pluggee/R1008/README.md

# R1008
Dual Platinum RTD Sensors
License
-------
R1008 is released under the GNU GPL v3, which you can find at <http://www.gnu.org/licenses/gpl-3.0.en.html>,
Check License.md for more details.
