pluggee/R1008/(threads)

Thread 2 (2017-03-24):

Fix silkscreen for signal polarity

pluggee, 2017-03-24:
Fix R1008 silkscreen, 1F+ instead of 1S+

Thread 4 (2017-06-26):

Fix BOM with 10k flash MCU instead of 2k

pluggee, 2017-06-26:
