pluggee/R1008/pcb/R1008.kicad_pcb

## KiCad design pcb/R1008.kicad_pcb (2017-06-27)

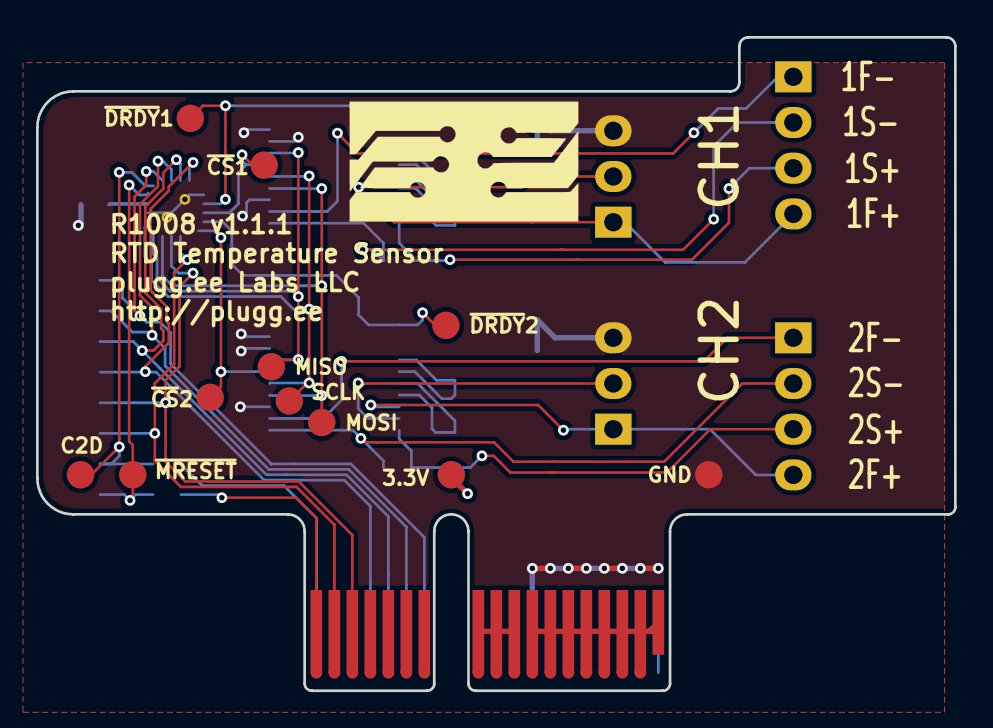
[picture p1: board R1008.kicad_pcb from above]

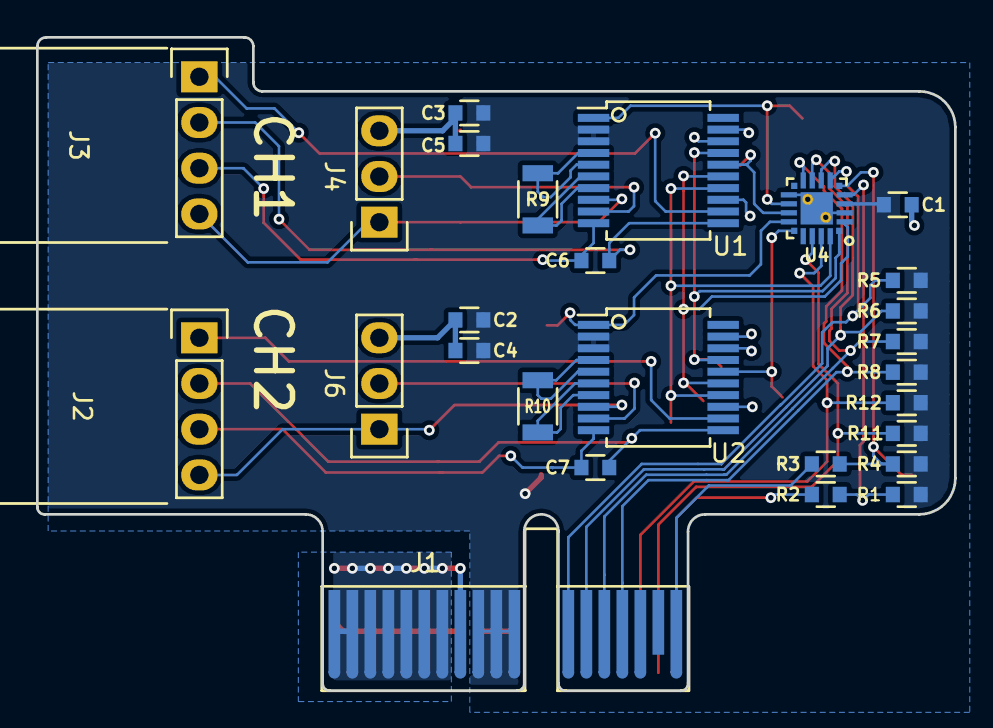
[picture p2: board R1008.kicad_pcb from below]

Board: 2 copper layers, 51.0 x 36.3 mm, 39 parts (27 on the bottom side), 35 nets.

Parts:
A1: ART; pluggeeLabsIcon-13X7
C1, C2, C3, C4, C5, C6, C7: CC0603KRX7R9BB104; CAPC0603
J1: PCIEXPRESS-X1
J2, J3: SOCKET254P-01X04-1725672; 70553-0038
J4, J6: CONN_01X03; CONN254P-01X03
R1, R4, R5, R6, R7, R8, R11, R12: RC0603FR-0710KL; RESC0603
R2, R3: RC0603FR-071KL; RESC0603
R9, R10: RN732BTTD4000B25; RESC1206
TP1, TP2, TP3, TP4, TP5, TP6, TP7, TP8, TP9, TP10, TP11: TestPoint; TestPoint000
U1, U2: MAX31865AAP+; SOP65P720X530X186-20
U4: EFM8BB10F8G; QFN50P300X300X75-20NT170X170

Connections:
+3V3: C1.1, C2.1, C3.1, C4.1, C5.1, J1.B9, J1.B10, J1.B11, R1.2, R4.2, R5.2, R6.2, R7.2, R8.2, R11.2, R12.2, TP1.1, U1.2, U1.3, U2.2, U2.3, U4.4
+5V: J1.A9, J1.A10, J1.A11
/C2D_CON: J1.B18, R3.2
/FORCE2_1: J4.2, U1.9
/FORCE2_2: J6.2, U2.9
/FORCE+_1: J3.4, J4.1, U1.8
/FORCE+_2: J2.4, J6.1, U2.8
/FORCE-_1: J3.1, U1.12
/FORCE-_2: J2.1, U2.12
/MISO: TP7.1, U1.17, U2.17, U4.1
/MOSI: TP9.1, U1.14, U2.14, U4.20
/R+_1: R9.1, U1.4, U1.5
/R+_2: R10.1, U2.4, U2.5
/R-_1: R9.2, U1.6, U1.7
/R-_2: R10.2, U2.6, U2.7
/RTDIN+_1: C6.1, J3.3, U1.10
/RTDIN+_2: C7.1, J2.3, U2.10
/RTDIN-_1: C6.2, J3.2, U1.11
/RTDIN-_2: C7.2, J2.2, U2.11
/SCLK: TP5.1, U1.15, U2.15, U4.2
/~CS~1: TP8.1, U1.16, U4.14
/~CS~2: TP11.1, U2.16, U4.16
/~DRDY~1: TP6.1, U1.1, U4.13
/~DRDY~2: TP10.1, U2.1, U4.15
/~MRESET~_CON: J1.A18, R2.1
C2D: R3.1, R4.1, TP3.1, U4.6
GND: C1.2, C2.2, C3.2, C4.2, C5.2, J1.B1, J1.B2, J1.B3, J1.B4, J1.B5, J1.B6, J1.B7, J1.B8, J4.3, J6.3, TP2.1, U1.13, U1.18, U1.19, U2.13, U2.18, U2.19, U4.3, U4.12, U4.21
HT: J1.A1, J1.A2, J1.A3, J1.A4, J1.A5, J1.A6, J1.A7, J1.A8
ID0: J1.B12, R5.1, U4.7
ID1: J1.B13, R6.1, U4.8
ID2: J1.B14, R7.1, U4.9
ID3: J1.B15, R8.1, U4.10
SCL: J1.A16, R12.1, U4.19
SDA: J1.A17, R11.1, U4.18
~MRESET: R1.1, R2.2, TP4.1, U4.5
