pluggee/R1008/firmware/R1008_bl/inc/smb.h

/*
 * smb.h
 *
 *  Created on: Feb 12, 2017
 *      Author: sherifeid
 */

#ifndef SMB_H_
#define SMB_H_

#define  WRITE                    0x00 // SMBus WRITE command
#define  READ                     0x01 // SMBus READ command

// Status vector - top 4 bits only
#define  SMB_SRADD                0x20 // (SR) slave address received
                                       //    (also could be a lost
                                       //    arbitration)
#define  SMB_SRSTO                0x10 // (SR) STOP detected while SR or ST,
                                       //    or lost arbitration
#define  SMB_SRDB                 0x00 // (SR) data byte received, or
                                       //    lost arbitration
#define  SMB_STDB                 0x40 // (ST) data byte transmitted
#define  SMB_STSTO                0x50 // (ST) STOP detected during a


void SetI2CSlaveAddress (void);
void SMBHandler(void);

#endif /* SMB_H_ */
