pluggee/R1008/firmware/R1008_fw/inc/EFM8BB1_SPI0_Master.h

//-----------------------------------------------------------------------------
// EFM8BB1_SPI0_Master.h
//-----------------------------------------------------------------------------
// Copyright 2014 Silicon Laboratories, Inc.
// http://developer.silabs.com/legal/version/v11/Silicon_Labs_Software_License_Agreement.txt
//
// Header for main file:

#ifndef SPI0_MASTER_H_
#define SPI0_MASTER_H_

//-----------------------------------------------------------------------------
// Global Constants
//-----------------------------------------------------------------------------

#define SYSCLK                24500000 // Internal oscillator frequency in Hz

#define SPI_CLOCK               500000 // Maximum SPI clock
                                       // The SPI clock is a maximum of 1 MHz
                                       // when this example is used with
                                       // the SPI0_Slave code example.

#define MAX_BUFFER_SIZE              8 // Maximum buffer Master will send

// Instruction Set
//#define  SLAVE_LED_ON             0x01 // Turn the Slave LED on
//#define  SLAVE_LED_OFF            0x02 // Turn the Slave LED off
#define  SPI_WRITE                0x04 // Send a byte from the Master to the
                                       // Slave
#define  SPI_READ                 0x08 // Send a byte from the Slave to the
                                       // Master
#define  SPI_WRITE_BUFFER         0x10 // Send a series of bytes from the
                                       // Master to the Slave
#define  SPI_READ_BUFFER          0x20 // Send a series of bytes from the Slave
                                       // to the Master
#define  ERROR_OCCURRED           0x40 // Indicator for the Slave to tell the
                                       // Master an error occurred

//-----------------------------------------------------------------------------
// Global Variables
//-----------------------------------------------------------------------------

extern uint8_t SPI_Data;

extern uint8_t SPI_Data_Array[MAX_BUFFER_SIZE];

extern bit Error_Flag;

extern uint8_t Command;

#endif // SPI0_MASTER_H_
//-----------------------------------------------------------------------------
// End Of File
//-----------------------------------------------------------------------------
