pluggee/R1008/(commit log)

2016-12-13 first commit, added pcb project
    [R1008.kicad_pcb, R1008.sch]
2016-12-14 ready for release, gerbers updated
    [R1008-B.Cu.gbr, R1008-B.Mask.gbr, R1008-B.Paste.gbr, R1008-B.SilkS.gbr, R1008-Edge.Cuts.gbr, R1008-F.Cu.gbr, R1008-F.Mask.gbr, R1008-F.Paste.gbr]
2016-12-14 re-confirmed gerbers, ready for release
    [R1008-B.Cu.gbr, R1008-B.Mask.gbr, R1008-B.Paste.gbr, R1008-B.SilkS.gbr, R1008-Edge.Cuts.gbr, R1008-F.Cu.gbr, R1008-F.Mask.gbr, R1008-F.Paste.gbr]
2017-01-11 updated BOM
    [R1008_BOM.csv]
2017-04-23 wip, ADC outputs are clean, theres a problem with FP calculations on 8bit mcu
    [R1008_fw_main.c, global.h, max31865.c, max31865.h]
2017-04-24 completely functional, got rid of casting problem that was causing weird floating point operations
    [R1008_fw_main.c, global.h, max31865.c, max31865.h]
2017-04-24 cleaned up code, still need to add code to measure internal die temeprature
2017-04-25 added internal temperature monitor, cleaned up, not properly documented yet
2017-04-27 added BOM, selected proper part for jumpers, added test points
    [R1008-B.Cu.gbr, R1008-B.Mask.gbr, R1008-B.Paste.gbr, R1008-B.SilkS.gbr, R1008-Edge.Cuts.gbr, R1008-F.Cu.gbr, R1008-F.Mask.gbr, R1008-F.Paste.gbr]
2017-04-27 regenerated gerbers
    [R1008-B.Cu.gbr, R1008-B.Mask.gbr, R1008-B.Paste.gbr, R1008-B.SilkS.gbr, R1008-Edge.Cuts.gbr, R1008-F.Cu.gbr, R1008-F.Mask.gbr, R1008-F.Paste.gbr]
2017-05-01 updated BOM with proper connector
    [R1008.sch, R1008_BOM.csv, R1008_BOM.ods, R1008_BOM.xlsx]
2017-06-27 ready for v1.1.1 release
    [R1008-B.Cu.gbr, R1008-B.Mask.gbr, R1008-B.Paste.gbr, R1008-B.SilkS.gbr, R1008-Edge.Cuts.gbr, R1008-F.Cu.gbr, R1008-F.Mask.gbr, R1008-F.Paste.gbr]
2017-09-02 updated firmware with 50Hz and 60Hz options
    [RTD_calculator.xlsx]
